ig20041975/In-Situ-Water-Quality-Sensor/media/sensor_package_2025 2.png

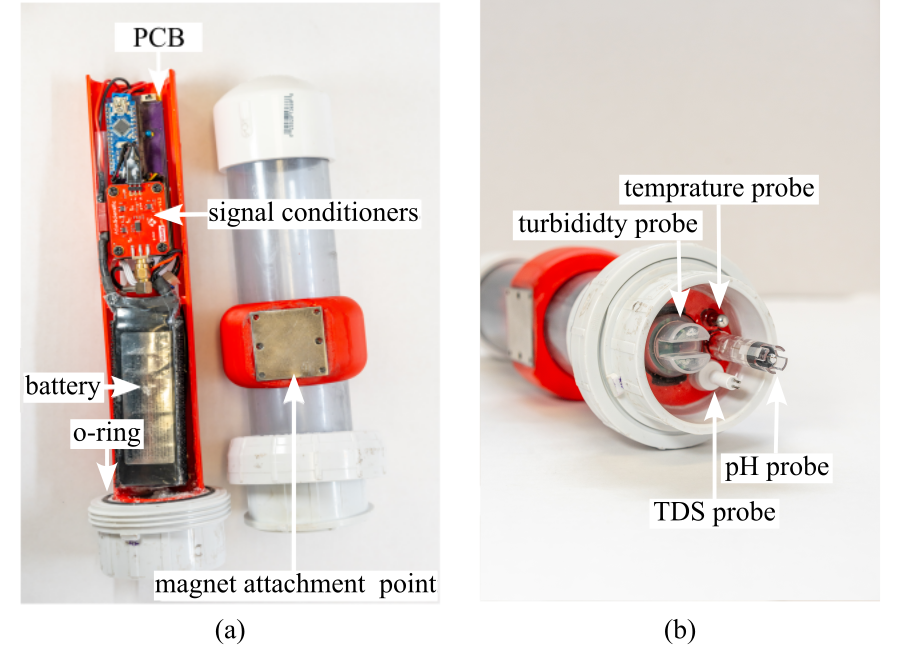
media/sensor_package_2025 2.png
