ig20041975/In-Situ-Water-Quality-Sensor/System_development/Jocassee/V0.5.1/Buoy/media/clamshell with roof.png

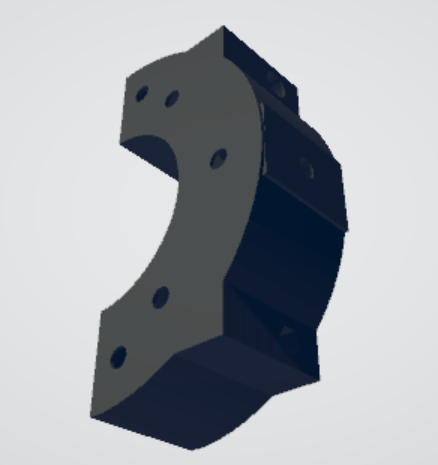
System_development/Jocassee/V0.5.1/Buoy/media/clamshell with roof.png
