ig20041975/In-Situ-Water-Quality-Sensor/System_development/Jocassee/V0.5.1/Buoy/media/sphere style buoy.png

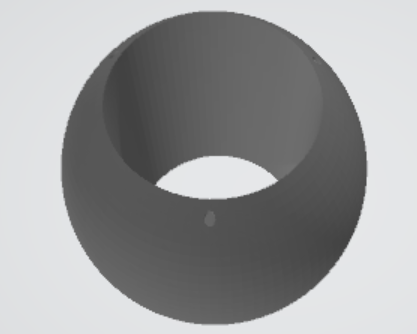
System_development/Jocassee/V0.5.1/Buoy/media/sphere style buoy.png
