ig20041975/In-Situ-Water-Quality-Sensor/System_development/Jocassee/V0.5.1/BIll_Of_Matirials/Parts for Int-Situ-Water-Quality-Sensor.docx

All Container Parts

Item (# of parts) (Grainger Part Number)

- PVC Female Adaptor (1) (1WJY4)
- Epoxy
- 3” Round Atrium Grate (1) (Home Depot)
- ABS Male Adaptor (1) (1WJD3)
- 1.5” by 1.5” steel plate (1) (We have steel)
- 14” long 2” diameter PVC Pipe (1) (788VR8 for 10ft white, 1AAZ8 for 8ft clear)
- ½” long ¼” diameter nut and bolt (2) (we have)
- 2” diameter O-ring (2) (2KAE2 is a 25 pack)
- Battery and PCB board tray 3D print (1)
- Steel plate holder 3D print (1)
- Buoy 3D Print (1)
- Spray Foam door and window
- PVC Glue (We have)

All Electronics

- Analog to digital converting PCB board (3)
- PCB board (1)
- Arduino Mini (1)
- JST XH 3 prong snap-in female wire connector (3)
- Dupont 3 prong female wire connector (3)
- pH sensor (1) (https://www.amazon.com/Atlas-Scientific-Consumer-Grade-Probe/dp/B07VDMNB92)
- Temperature sensor (1) (https://www.amazon.com/HiLetgo-DS18B20-Temperature-Stainless-Waterproof/dp/B00M1PM55K)
- TDS sensor (1) (https://www.amazon.com/KEYESTUDIO-Quality-Monitoring-XH2-54-3Pin-Connector/dp/B08DGLY3J2?link_code=qs)
- Turbidity sensor (1) (https://www.newark.com/amphenol-advanced-sensors/tsd-10/turbidity-sensor-5vdc-phototransistor/dp/18X9859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)
