ig20041975/In-Situ-Water-Quality-Sensor/System_development/Jocassee/V0.5.1/BIll_Of_Matirials/Water quality V0.5 BOM.xlsx

Sheet: Electronics BOM
PCB Reference | Component spec / part number | Qty | Unit cost (USD) | Net cost (USD) | Vendor 1 | Vendor 2 | Vendor 3
C1 0.1uF | Capacitor_SMD:C_1206_3216Metric_Pad1.33x1.80mm_HandSolder | 1 | 0.11 | 0.11 | https://www.digikey.com/en/products/detail/nextgen-components/1206B104K500BD/15776047
U3 | SWITCH OS102011MS2QN1 | 1 | 0.71 | 0.71 | https://www.digikey.com/en/products/detail/c-k/OS102011MS2QN1/411602 | https://www.mouser.com/ProductDetail/CK/OS102011MS2QN1?qs=WtljUlYws5RvQ1hEv876nQ%3D%3D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 | https://www.jameco.com/z/OS102011MS2QN1-C-K-Slide-Switch-SPDT-ON-ON-100mA-12VDC-Through-Hole-5-08mm-Pitch_2313927.html
D1 | LED 3.0mm | 1 | 0.16 | 0.16 | https://www.digikey.com/en/products/detail/w%C3%BCrth-elektronik/151033RS03000/4490003
U2 | SD card module | 1 | 1.69 | 1.69 | https://www.ebay.com/itm/203852249807?_skw=SD+card+module+mini&itmmeta=01JWS7YRSNYRE9JPQ1403XF1SB
A1 | Arduino Nano | 1 | 3.67 | 3.67 | https://www.ebay.com/itm/283932038203?_skw=arduino+nano&itmmeta=01JWS81PY2BK5W7AA2FK7T4DBS
U6 | DS3231M+ | 1 | 10.98 | 10.98 | https://www.digikey.com/en/products/detail/analog-devices-inc-maxim-integrated/DS3231M-TRL/2402421 | https://www.mouser.com/ProductDetail/Analog-Devices-Maxim-Integrated/DS3231M+TRL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
BT1 | Coin cell Battery Holder BK-870 | 1 | 0.58 | 0.58 | https://www.digikey.com/en/products/detail/mpd-memory-protection-devices/BK-870/3829737
U8 | 3pin XH2.54 male connector (https://www.digikey.com/en/products/detail/jst-sales-america-inc/B3B-XH-A/1651046) | 1 | 0.13 | 0.13 | https://www.digikey.com/en/products/detail/jst-sales-america-inc/B3B-XH-A/1651046
R2 470ohm | Resistor_SMD:R_1206_3216Metric_Pad1.30x1.75mm_HandSolder | 1 | 0.1 | 0.1 | https://www.digikey.com/en/products/detail/bourns-inc/CR1206-JW-471ELF/3741054
R1 4.7K | Resistor_SMD:R_1206_3216Metric_Pad1.30x1.75mm_HandSolder | 1 | 0.1 | 0.1 | https://www.digikey.com/en/products/detail/bourns-inc/CR1206-JW-472ELF/3785627
N/A | Coin cell battery CR-1025-ND | 1 | 1.09 | 1.09 | https://www.digikey.com/en/products/detail/jauch-quartz/CR1025/16399048
N/A | 11.1V 3300mAH Lipo battery with T connector | 1 | 46.72 | 46.72 | https://us.ovonicshop.com/products/2-ovonic-3000mah-3s-50c-lipo-battery-11-1v-long-with-t-plug-for-aircraft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 | https://www.ebay.com/itm/184508325888?chn=ps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 | https://www.motionrc.com/products/admiral-3300mah-3s-11-1v-30c-lipo-battery-with-t-connector-epr33003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
N/A | Atlas pH conditioning circuit | 1 | 26.11 | 26.11 | https://www.digikey.com/en/products/detail/atlas-scientific/SRV-PH/16003016?gad_source=1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
N/A | Turbidity conditioning circuit and sensor | 1 | 9.9 | 9.9 | https://www.digikey.com/en/products/detail/dfrobot/SEN0189/6588606?gad_source=1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 | https://www.keyestudio.com/products/keyestudio-turbidity-sensor-v10-with-wires-compatible-with-arduino-for-water-testing
N/A | pH probe ENV 30 | 1 | 49.99 | 49.99 | https://www.digikey.com/en/products/detail/atlas-scientific/ENV-30-PH/16003028?gad_source=1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 | https://atlas-scientific.com/probes/consumer-grade-ph-probe/
N/A | TDS probe and conditioning circuit | 1 | 19.95 | 19.95 | https://www.ebay.com/itm/184291373846?chn=ps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 | https://www.keyestudio.com/products/keyestudio-tds-meter-v10-board-module-water-meter-filter-measuring-water-quality-for-arduino-unor3
N/A | ds18b20 temperature sensor | 1 | 2.55 | 2.55 | https://www.ebay.com/itm/224193475936?_skw=ds18b20&itmmeta=01JWS9436Y9FERAQTKDM3HA2HJ | https://www.dfrobot.com/product-689.html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
N/A | Male T connector for lipo | 1 | 1.25 | 1.25 | https://www.digikey.com/en/products/detail/sparkfun-electronics/11864/6818769?gad_source=1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 | https://rcbattery.com/deans-style-t-connector-plug-male-side-5pcs-bag.html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
N/A | 15 pin female header 2.54 mm | 2 | 2.2 | 4.4 | https://www.digikey.com/en/products/detail/samtec-inc/SSW-115-01-F-S/7879494?gad_source=1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
N/A | PCB itself | 1 | 8 | 8 | https://oshpark.com/
 |  |  | Total | 188.08

Sheet: Fixture BOM
Component | Qty per sensor | Unit price (USD) | Net price (USD) | vendor 1 | vendor 2 | vendor 3
PVC union | 1 | 19.56 | 19.56 | https://www.grainger.com/product/22FL17?RIID=51819294775&GID=729415832 | https://www.homedepot.com/pep/Apollo-2-in-x-2-in-PVC-Slip-Joint-x-Slip-Joint-Union-PVCU2/317901067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
Schedule 40 clear PVC pipe | 10 inches | 69.69 | 7.26 | https://www.grainger.com/product/1AAZ8?gclsrc=aw.ds&gad_source=1&gad_campaignid=21375667808
Schedule 40 socket cap | 1 | 1.47 | 1.47 | https://www.grainger.com/product/22FJ37?RIID=51819294775&GID=729415832 | https://www.homedepot.com/pep/Charlotte-Pipe-2-in-PVC-Socket-Schedule-40-Pressure-Cap-PVC021161600HD/203811678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 | https://www.homedepot.com/pep/Charlotte-Pipe-2-in-OD-PVC-Test-Cap-Fitting-PVC-00132-0800HD/203947220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
M3 standoofs 8mm | 12 | 1.13 | 13.56 | https://www.digikey.com/en/products/detail/w%C3%BCrth-elektronik/971080365/9488753
M3 standoffs 6mm | 4 | 0.85 | 3.4 | https://www.digikey.com/en/products/detail/w%C3%BCrth-elektronik/971060365/9488747
M3 nylon hex nut | 4 | 0.13 | 0.52 | https://www.digikey.com/en/products/detail/keystone-electronics/4688/4499297?gad_source=1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
2 part clear epoxy | 1 pack | 47.86 | 47.86 | https://www.grainger.com/product/25F529?gad_source=1&gad_campaignid=21369464154&gclsrc=aw.ds | https://www.ebay.com/itm/365353922077?itmmeta=01JZNA1PV76QEB7T5CVVGGADC6 | https://www.grainger.com/product/PC-PRODUCTS-Epoxy-Adhesive-PC-11-4AUV9?opr=ODOH&analytics=FM:Order%20History
 |  |  | 93.63
