ig20041975/In-Situ-Water-Quality-Sensor/System_development/Jocassee/V0.5.1/Buoy/Buoy Torus v1.stl

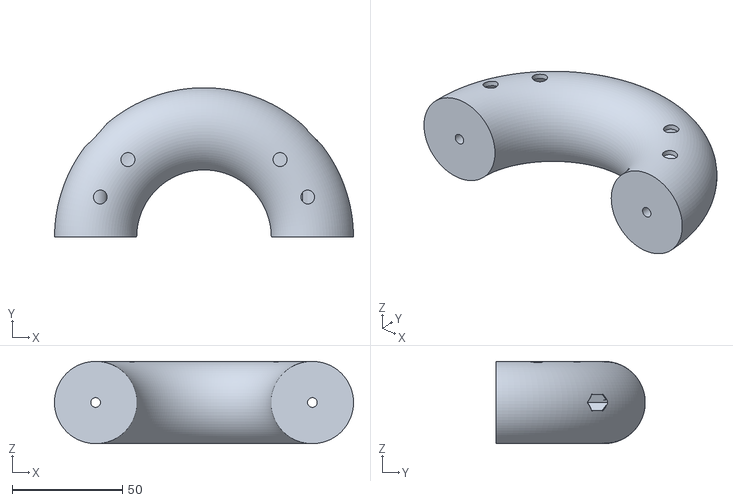
[picture p6: CAD file, 2025-07-18]
System_development/Jocassee/V0.5.1/Buoy/Buoy Torus v1.stl
135.4 x 67.7 x 37.2
