ig20041975/In-Situ-Water-Quality-Sensor/System_development/Jocassee/V0.5.1/Chassis/CAD model of Water Sensor/Printable Grate v2.stl

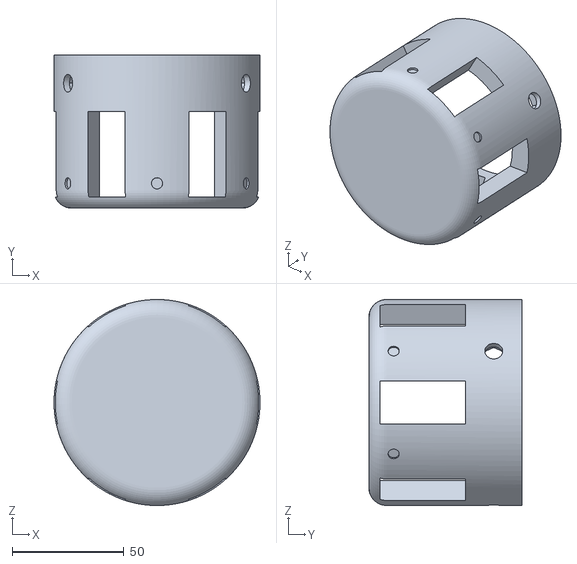
[picture p7: CAD file, 2025-08-21]
System_development/Jocassee/V0.5.1/Chassis/CAD model of Water Sensor/Printable Grate v2.stl
92.0 x 68.5 x 92.0
