ig20041975/In-Situ-Water-Quality-Sensor/System_development/Jocassee/V0.5.1/Drop Mechanism/Bouy.stl

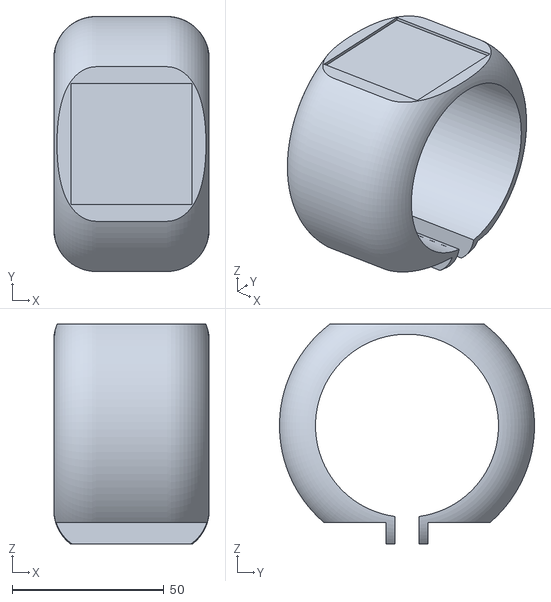
[picture p8: CAD file, 2025-07-17]
System_development/Jocassee/V0.5.1/Drop Mechanism/Bouy.stl
51.0 x 84.1 x 72.4
