ig20041975/In-Situ-Water-Quality-Sensor/System_development/Jocassee/V0.5.1/Chassis/CAD model of Water Sensor/Printable Grate v1.step

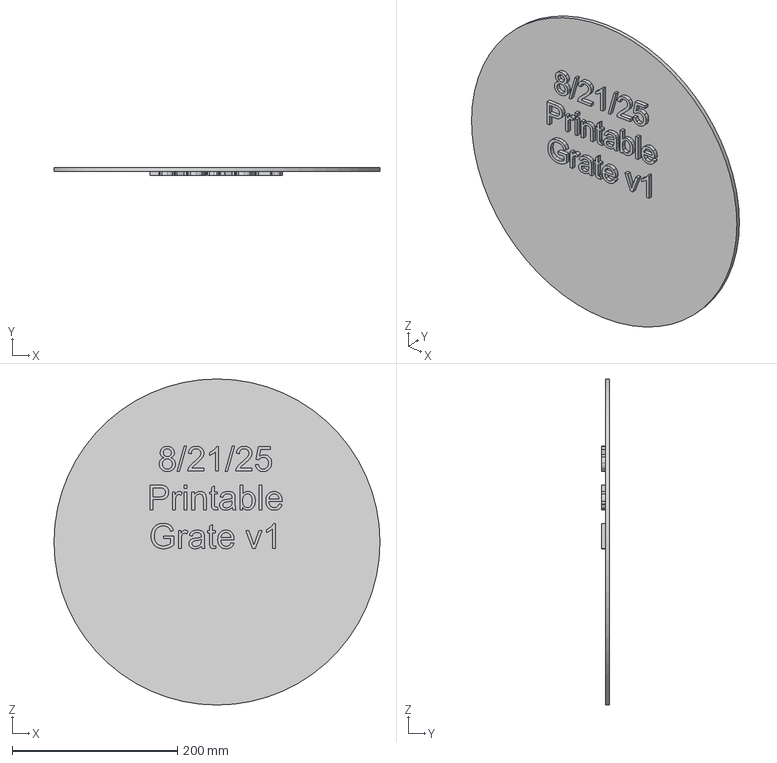
[picture p9: CAD file, 2025-08-21]
System_development/Jocassee/V0.5.1/Chassis/CAD model of Water Sensor/Printable Grate v1.step
395.0 x 10.0 x 395.0 mm
