ig20041975/In-Situ-Water-Quality-Sensor/System_development/Jocassee/V0.5.1/Chassis/CAD model of Water Sensor/Printable Grate.3mf

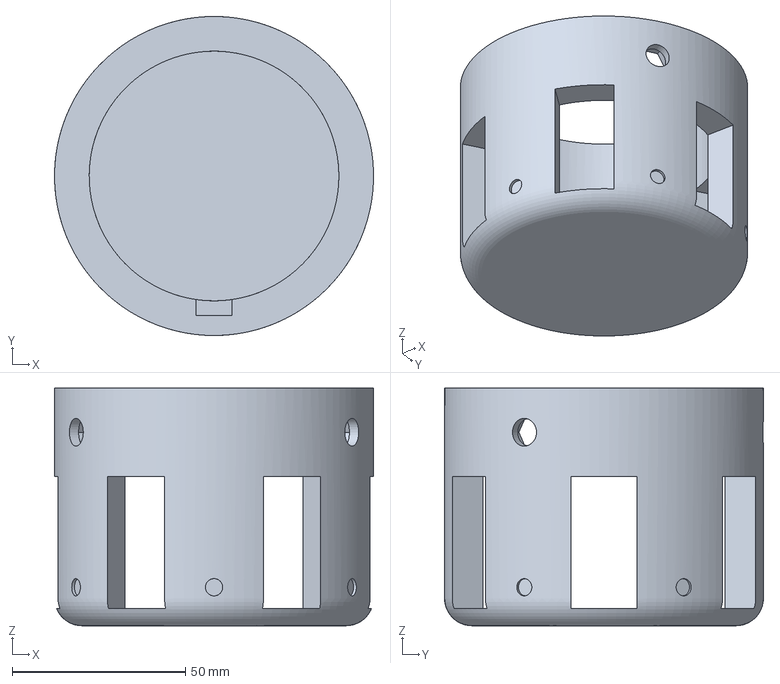
[picture p10: CAD file, 2025-08-19]
System_development/Jocassee/V0.5.1/Chassis/CAD model of Water Sensor/Printable Grate.3mf
92.0 x 92.0 x 68.5 mm
