ig20041975/In-Situ-Water-Quality-Sensor/System_development/Jocassee/V0.5.1/Chassis/CAD model of Water Sensor/PCB tray CAD.3mf

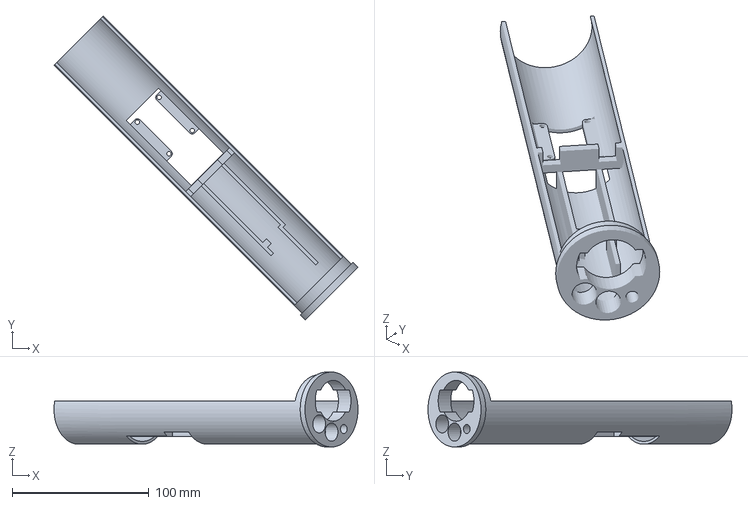
[picture p11: CAD file, 2025-07-17]
System_development/Jocassee/V0.5.1/Chassis/CAD model of Water Sensor/PCB tray CAD.3mf
222.3 x 222.3 x 54.8 mm
