ig20041975/In-Situ-Water-Quality-Sensor/System_development/Jocassee/V0.5.1/Chassis/CAD model of Water Sensor/Spacer for PCB boards.stl

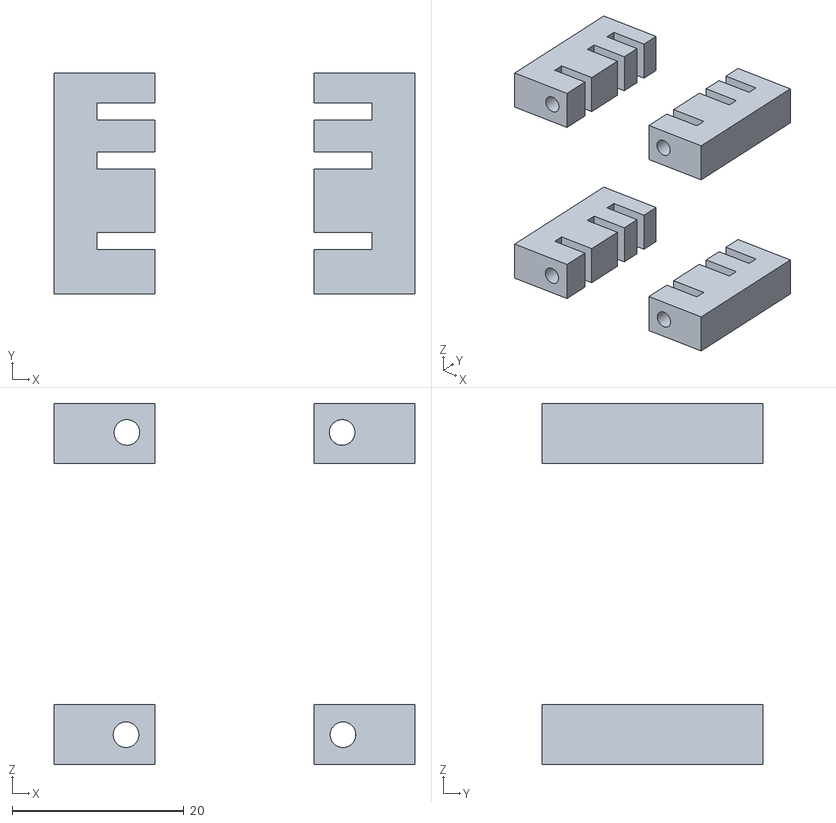
[picture p12: CAD file, 2025-07-17]
System_development/Jocassee/V0.5.1/Chassis/CAD model of Water Sensor/Spacer for PCB boards.stl
42.1 x 25.7 x 42.2
