ig20041975/In-Situ-Water-Quality-Sensor/System_development/Jocassee/V0.5.1/Chassis/CAD model of Water Sensor/Water_Sensor_Cap.stl

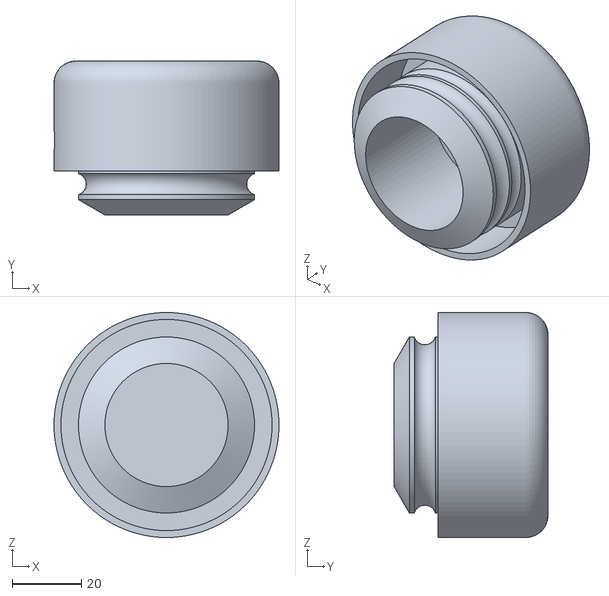
[picture p13: CAD file, 2025-07-17]
System_development/Jocassee/V0.5.1/Chassis/CAD model of Water Sensor/Water_Sensor_Cap.stl
65.0 x 44.4 x 65.0
