ig20041975/In-Situ-Water-Quality-Sensor/System_development/Jocassee/V0.5.1/Buoy/eyebolt compatible/Clamshell with roof/CE3V3KE_buoy version 16.5.4 eyeboltipt.3mf

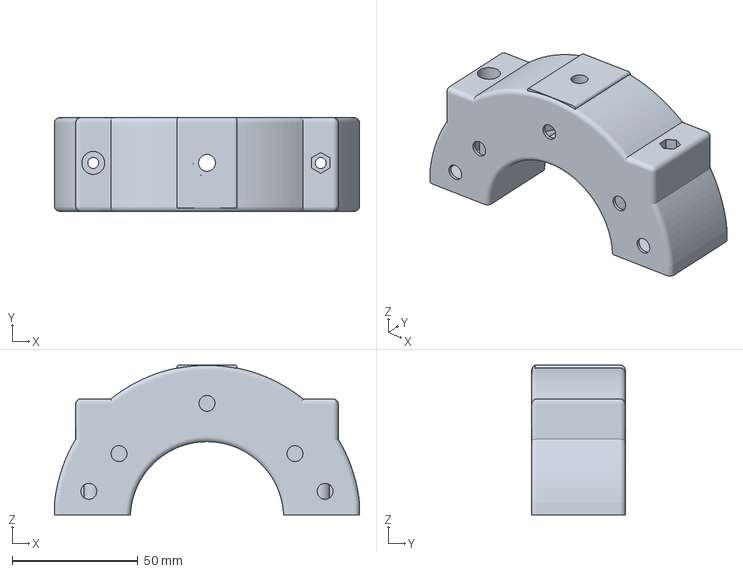
[picture p15: CAD file, 2025-07-17]
System_development/Jocassee/V0.5.1/Buoy/eyebolt compatible/Clamshell with roof/CE3V3KE_buoy version 16.5.4 eyeboltipt.3mf
121.3 x 37.2 x 59.6 mm
