ig20041975/In-Situ-Water-Quality-Sensor/System_development/Jocassee/V0.5.1/Buoy/eyebolt compatible/clamshell no roof/buoy versio 15.7 clamshell no roof.stl

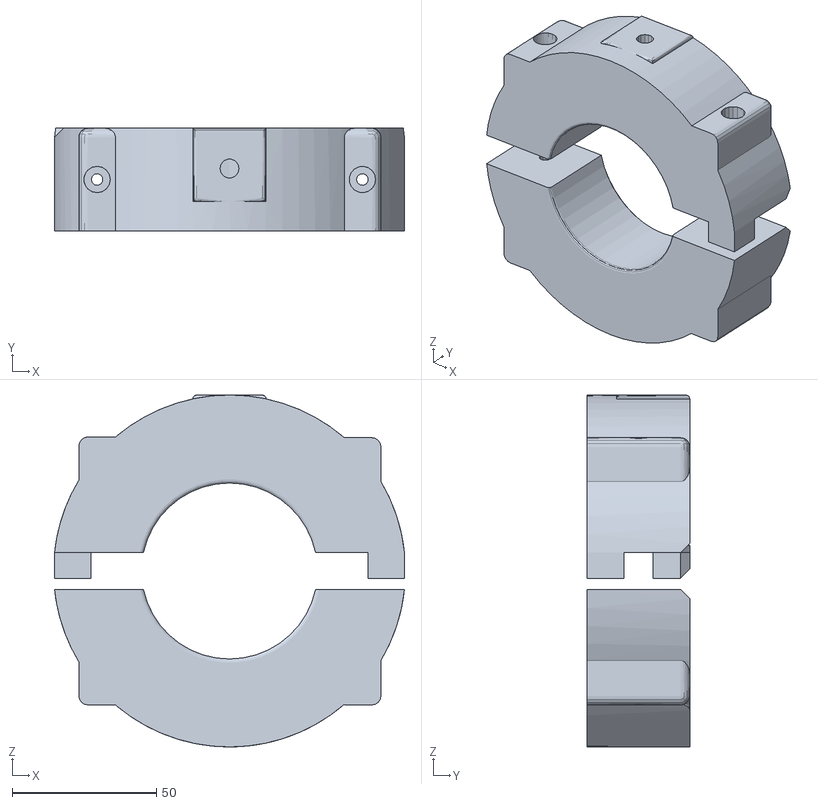
[picture p16: CAD file, 2025-06-23]
System_development/Jocassee/V0.5.1/Buoy/eyebolt compatible/clamshell no roof/buoy versio 15.7 clamshell no roof.stl
121.3 x 35.6 x 121.9
