ig20041975/In-Situ-Water-Quality-Sensor/System_development/Jocassee/V0.5.1/Buoy/eyebolt compatible/Clamshell with roof/buoy versio 15.5 clamshell with ibolt connection.stl

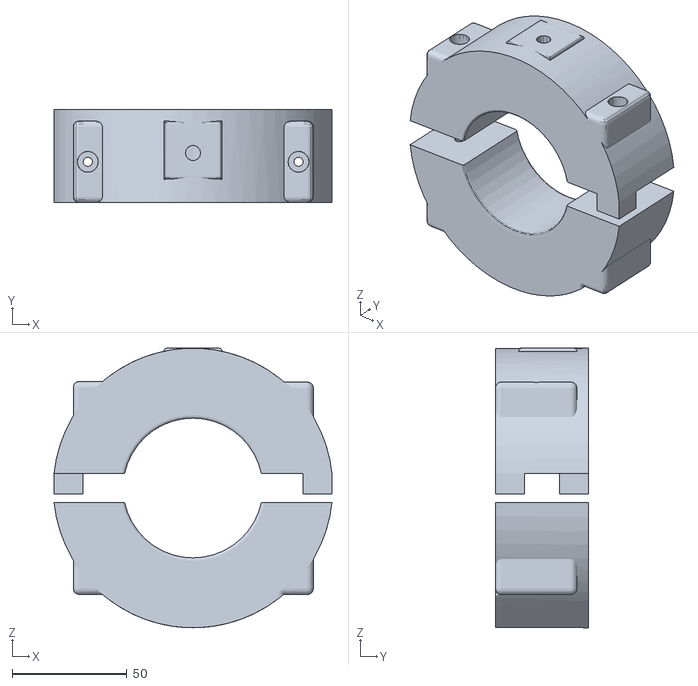
[picture p17: CAD file, 2025-07-17]
System_development/Jocassee/V0.5.1/Buoy/eyebolt compatible/Clamshell with roof/buoy versio 15.5 clamshell with ibolt connection.stl
121.3 x 40.6 x 121.9
