ig20041975/In-Situ-Water-Quality-Sensor/System_development/Jocassee/V0.5.1/Buoy/eyebolt compatible/Clamshell with roof/buoy version 16.5.2 edited eyeboltipt.stl

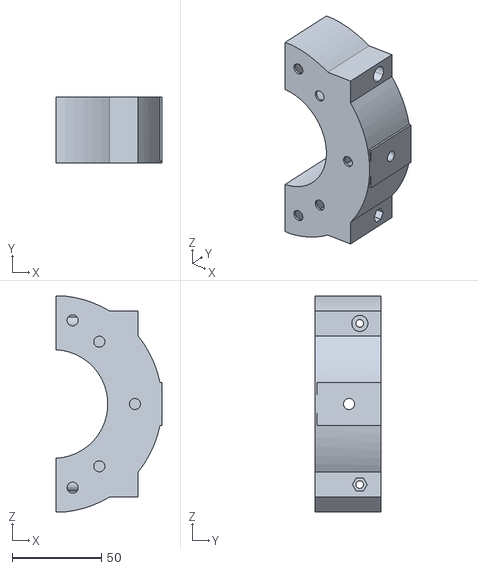
[picture p18: CAD file, 2025-07-17]
System_development/Jocassee/V0.5.1/Buoy/eyebolt compatible/Clamshell with roof/buoy version 16.5.2 edited eyeboltipt.stl
59.6 x 37.2 x 121.3
