ig20041975/In-Situ-Water-Quality-Sensor/System_development/Jocassee/V0.5.1/Buoy/eyebolt compatible/Clamshell with roof/buoy version 16.5.5 eyeboltipt.step

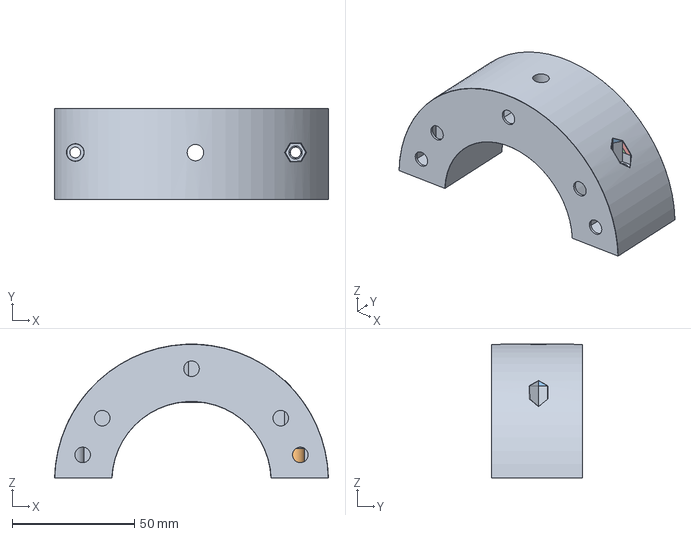
[picture p19: CAD file, 2025-07-17]
System_development/Jocassee/V0.5.1/Buoy/eyebolt compatible/Clamshell with roof/buoy version 16.5.5 eyeboltipt.step
112.0 x 37.2 x 54.7 mm
