ig20041975/In-Situ-Water-Quality-Sensor/System_development/Jocassee/V0.5.1/Buoy/eyebolt compatible/Clamshell with roof/buoy version 16.stl

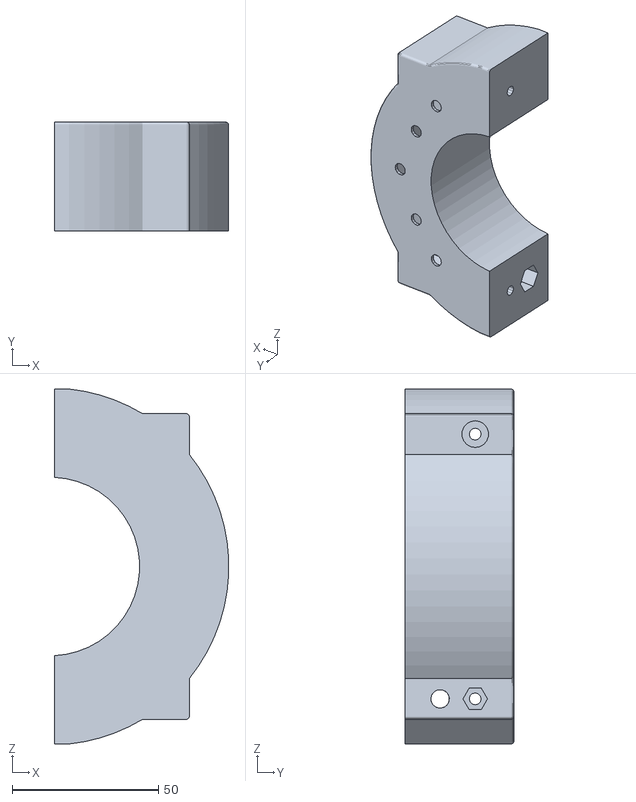
[picture p20: CAD file, 2025-06-23]
System_development/Jocassee/V0.5.1/Buoy/eyebolt compatible/Clamshell with roof/buoy version 16.stl
59.6 x 37.2 x 121.3
