ig20041975/In-Situ-Water-Quality-Sensor/(list of files, cad)

Other CAD files:
System_development/Jocassee/V0.5.1/Chassis/CAD model of Water Sensor/Printable Grate.gcode.3mf
System_development/Jocassee/V0.5.1/Buoy/eyebolt compatible/Clamshell with roof/buoy version 16.5.4 eyeboltipt.3mf
System_development/Jocassee/V0.5.1/Buoy/eyebolt compatible/Clamshell with roof/buoy version 16.5.4 eyeboltipt v1.step
System_development/Jocassee/V0.5.0/Buoy/Buoy 11 8inx1in shpere.ipt
System_development/Jocassee/V0.5.0/Buoy/Buoy 11 8inx1in shpere.stl
System_development/Jocassee/V0.5.0/Buoy/Buoy 12 7inx1in shpere.ipt
System_development/Jocassee/V0.5.0/Buoy/Buoy 12 7inx1in shpere.stl
System_development/Jocassee/V0.5.0/Buoy/OldVersions/buoy version 16.0002.ipt
System_development/Jocassee/V0.5.0/Buoy/buoy version 15.6 expairamenting with wall thinknes (do not print this yet).ipt
System_development/Jocassee/V0.5.1/Buoy/Buoy Torus v1.ipt
System_development/Jocassee/V0.5.1/Buoy/OldVersions/clamshell buoys/buoy versio 15 clamshellipt.0001.ipt
System_development/Jocassee/V0.5.1/Buoy/OldVersions/sphere buoys/Buoy 11 8inx1in shpere.ipt
System_development/Jocassee/V0.5.1/Buoy/OldVersions/sphere buoys/Buoy 11 8inx1in shpere.stl
System_development/Jocassee/V0.5.1/Buoy/OldVersions/sphere buoys/Buoy 12 7inx1in shpere.ipt
System_development/Jocassee/V0.5.1/Buoy/OldVersions/sphere buoys/Buoy 12 7inx1in shpere.stl
System_development/Jocassee/V0.5.1/Buoy/eyebolt compatible/Clamshell with roof/OldVersions/buoy version 16.5.3 eyeboltipt.0001.ipt
System_development/Jocassee/V0.5.1/Buoy/eyebolt compatible/Clamshell with roof/buoy versio 15.1 clamshell with ibolt connection.ipt
System_development/Jocassee/V0.5.1/Buoy/eyebolt compatible/Clamshell with roof/buoy versio 15.5 clamshell with ibolt connection.ipt
System_development/Jocassee/V0.5.1/Buoy/eyebolt compatible/Clamshell with roof/buoy version 16.5 edited eyeboltipt.0001.ipt
System_development/Jocassee/V0.5.1/Buoy/eyebolt compatible/Clamshell with roof/buoy version 16.5 edited eyeboltipt.ipt
System_development/Jocassee/V0.5.1/Buoy/eyebolt compatible/Clamshell with roof/buoy version 16.5 edited eyeboltipt.stl
System_development/Jocassee/V0.5.1/Buoy/eyebolt compatible/Clamshell with roof/buoy version 16.5.1 edited eyeboltipt.dwg
System_development/Jocassee/V0.5.1/Buoy/eyebolt compatible/Clamshell with roof/buoy version 16.5.1 edited eyeboltipt.ipt
System_development/Jocassee/V0.5.1/Buoy/eyebolt compatible/Clamshell with roof/buoy version 16.5.1 edited eyeboltipt.stl
System_development/Jocassee/V0.5.1/Buoy/eyebolt compatible/Clamshell with roof/buoy version 16.5.2 edited eyeboltipt.ipt
System_development/Jocassee/V0.5.1/Buoy/eyebolt compatible/Clamshell with roof/buoy version 16.5.3 eyeboltipt.3mf
System_development/Jocassee/V0.5.1/Buoy/eyebolt compatible/Clamshell with roof/buoy version 16.5.3 eyeboltipt.ipt
System_development/Jocassee/V0.5.1/Buoy/eyebolt compatible/Clamshell with roof/buoy version 16.5.3 eyeboltipt.stl
System_development/Jocassee/V0.5.1/Buoy/eyebolt compatible/Clamshell with roof/buoy version 16.5.4 eyeboltipt.ipt
System_development/Jocassee/V0.5.1/Buoy/eyebolt compatible/Clamshell with roof/buoy version 16.5.4 eyeboltipt.stl
System_development/Jocassee/V0.5.1/Buoy/eyebolt compatible/Clamshell with roof/buoy version 16.ipt
System_development/Jocassee/V0.5.1/Buoy/eyebolt compatible/clamshell no roof/buoy versio 15.7 clamshell no roof.0001.ipt
System_development/Jocassee/V0.5.1/Buoy/eyebolt compatible/clamshell no roof/buoy versio 15.7 clamshell no roof.ipt
System_development/Jocassee/V0.5.1/Buoy/eyebolt compatible/non-clamshell designs/Bouy versioun 14 not an stl file.ipt
System_development/Jocassee/V0.5.1/Buoy/eyebolt compatible/non-clamshell designs/I-bolt compatable floater for in-situ water detection v13.ipt
System_development/Jocassee/V0.5.1/Buoy/eyebolt compatible/non-clamshell designs/i-bolt compatible buoy v13 square.ipt
System_development/Jocassee/V0.5.1/Chassis/CAD model of Water Sensor/Assembled Water Sensor Chassi.iam
System_development/Jocassee/V0.5.1/Chassis/CAD model of Water Sensor/CADs for Water Sensor assembly/Arc Water Sensor.ipt
System_development/Jocassee/V0.5.1/Chassis/CAD model of Water Sensor/CADs for Water Sensor assembly/Battery for Water Sensor.ipt
System_development/Jocassee/V0.5.1/Chassis/CAD model of Water Sensor/CADs for Water Sensor assembly/Light Water Sensor.ipt
System_development/Jocassee/V0.5.1/Chassis/CAD model of Water Sensor/CADs for Water Sensor assembly/Male Adaptor to Water Sensor.ipt
System_development/Jocassee/V0.5.1/Chassis/CAD model of Water Sensor/CADs for Water Sensor assembly/OldVersions/PCB Board.0002.ipt
System_development/Jocassee/V0.5.1/Chassis/CAD model of Water Sensor/CADs for Water Sensor assembly/PCB Board.ipt
System_development/Jocassee/V0.5.1/Chassis/CAD model of Water Sensor/CADs for Water Sensor assembly/Pipe Joiner for Water Sensor.ipt
System_development/Jocassee/V0.5.1/Chassis/CAD model of Water Sensor/CADs for Water Sensor assembly/Temp Water Sensor.ipt
System_development/Jocassee/V0.5.1/Chassis/CAD model of Water Sensor/CADs for Water Sensor assembly/Water Sensor Grate.ipt
System_development/Jocassee/V0.5.1/Chassis/CAD model of Water Sensor/CADs for Water Sensor assembly/Water Sensor Shaft (For assembly only).ipt
System_development/Jocassee/V0.5.1/Chassis/CAD model of Water Sensor/CADs for Water Sensor assembly/pH Sensor.ipt
System_development/Jocassee/V0.5.1/Chassis/CAD model of Water Sensor/OldVersions/Assembled Water Sensor Chassi.0010.iam
System_development/Jocassee/V0.5.1/Chassis/CAD model of Water Sensor/OldVersions/PCB tray CAD.0050.ipt
System_development/Jocassee/V0.5.1/Chassis/CAD model of Water Sensor/OldVersions/PCB tray CAD.0051.ipt
System_development/Jocassee/V0.5.1/Chassis/CAD model of Water Sensor/OldVersions/Printable Grate.0003.ipt
System_development/Jocassee/V0.5.1/Chassis/CAD model of Water Sensor/OldVersions/Printable Grate.0004.ipt
System_development/Jocassee/V0.5.1/Chassis/CAD model of Water Sensor/OldVersions/Printable Grate.0005.ipt
System_development/Jocassee/V0.5.1/Chassis/CAD model of Water Sensor/OldVersions/Printable Grate.0007.ipt
System_development/Jocassee/V0.5.1/Chassis/CAD model of Water Sensor/OldVersions/Spacer for PCB boards.0019.ipt
System_development/Jocassee/V0.5.1/Chassis/CAD model of Water Sensor/OldVersions/Water_Sensor_Cap.0028.ipt
System_development/Jocassee/V0.5.1/Chassis/CAD model of Water Sensor/OldVersions/Water_Sensor_Cap.0029.ipt
System_development/Jocassee/V0.5.1/Chassis/CAD model of Water Sensor/OldVersions/Water_Sensor_Cap.0030.ipt
System_development/Jocassee/V0.5.1/Chassis/CAD model of Water Sensor/PCB tray CAD.ipt
System_development/Jocassee/V0.5.1/Chassis/CAD model of Water Sensor/PCB tray CAD.stl
System_development/Jocassee/V0.5.1/Chassis/CAD model of Water Sensor/Printable Grate v1.stl
System_development/Jocassee/V0.5.1/Chassis/CAD model of Water Sensor/Printable Grate v2.ipt
System_development/Jocassee/V0.5.1/Chassis/CAD model of Water Sensor/Printable Grate.ipt
System_development/Jocassee/V0.5.1/Chassis/CAD model of Water Sensor/Printable Grate.stl
System_development/Jocassee/V0.5.1/Chassis/CAD model of Water Sensor/RC plane design copy (wider design).f3d
System_development/Jocassee/V0.5.1/Chassis/CAD model of Water Sensor/Spacer for PCB boards.ipt
System_development/Jocassee/V0.5.1/Chassis/CAD model of Water Sensor/Water_Sensor_Cap.ipt
System_development/Jocassee/V0.5.1/Chassis/CADs for Water Sensor assembly/OldVersions/PCB Board.0002.ipt
System_development/Jocassee/V0.5.1/Chassis/CADs for Water Sensor assembly/PCB Board.ipt
System_development/Jocassee/V0.5.1/Drop Mechanism/DroneDeploymentMechanism.ipt
System_development/Jocassee/V0.5.1/Drop Mechanism/OldVersions/Part2.0001.ipt
