ig20041975/In-Situ-Water-Quality-Sensor/System_development/Jocassee/V0.5.1/PCB/V0.5.0/V0.5.0.kicad_pcb

## KiCad design System_development/Jocassee/V0.5.1/PCB/V0.5.0/V0.5.0.kicad_pcb (2025-07-08)

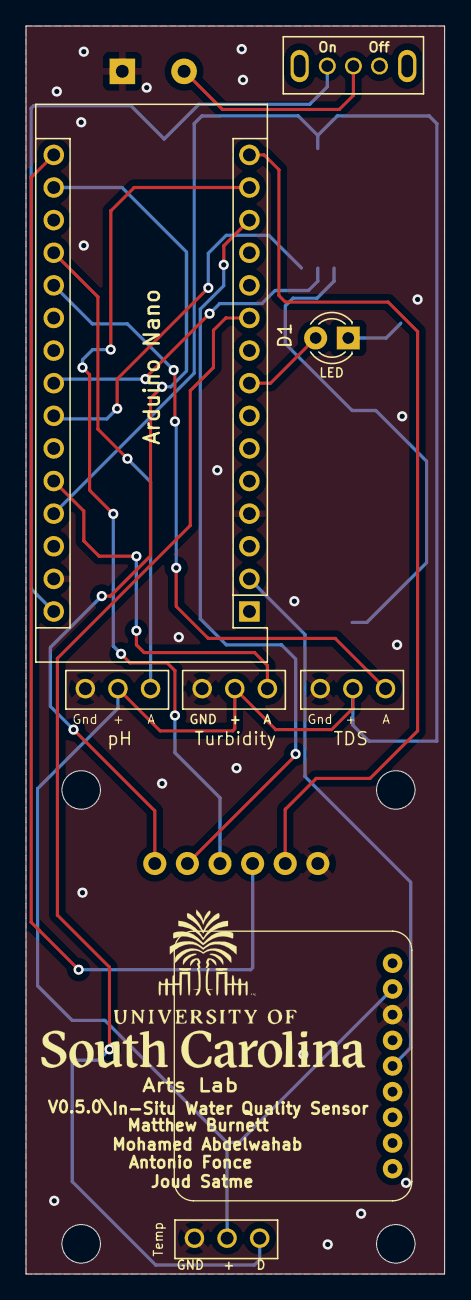
[picture p21: board V0.5.0.kicad_pcb from above]

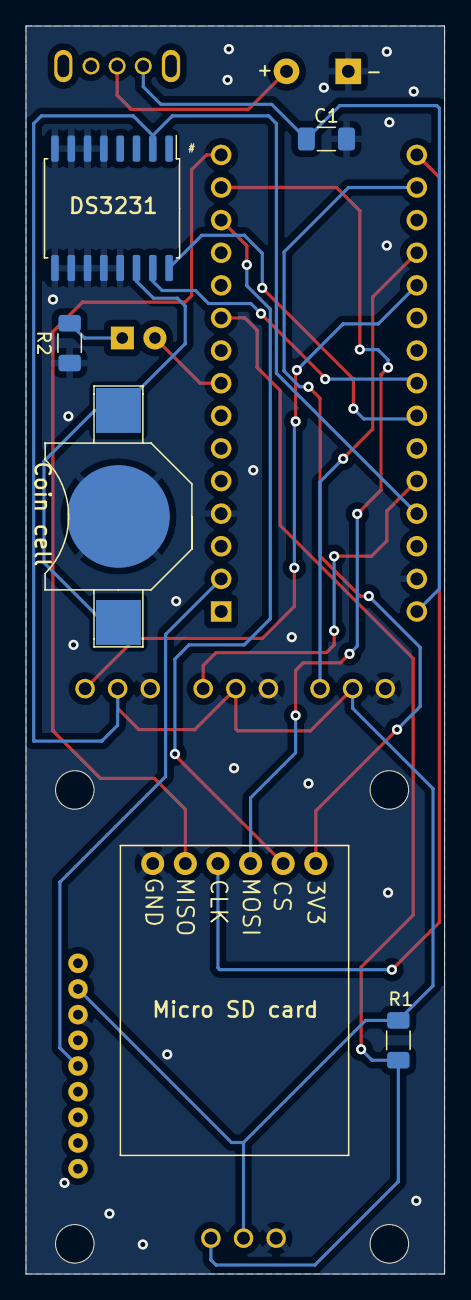
[picture p22: board V0.5.0.kicad_pcb from below]

Board: 2 copper layers, 32.6 x 97.2 mm, 15 parts (7 on the bottom side), 19 nets.

Parts:
A1: Arduino_Nano_v3.x; Arduino_Nano
BT1: Battery_Cell; battery_holder_10mm
C1: C; C_1206_3216Metric_Pad1.33x1.80mm_HandSolder
D1: LED; LED_D3.0mm
R1, R2: R; R_1206_3216Metric_Pad1.30x1.75mm_HandSolder
U1: water_Battery; Battery_Input
U2: SD
U3: switch; grounded_switch
U4: pH; phraails
U5: Sensor; TDS
U6: DS3231M; SOIC-16W_7.5x10.3mm_P1.27mm
U7: Sensor; Turbidity
U8: Temp; Temp.
U9: GPS Module

Connections:
GND: A1.4 (GND), A1.29 (GND), BT1.2 (-), C1.2, R2.2, U1.2 (Gnd), U2.6 (GND), U4.1 (GND), U5.1 (GND), U6.5 (GND), U6.6 (GND), U6.7 (GND), U6.8 (GND), U6.9 (GND), U6.10 (GND), U6.11 (GND), U6.12 (GND), U6.13 (GND), U7.1 (GND), U8.1 (Gnd), U9.7 (GND)
unnamed: A1.17 (3V3), U2.1 (3V)
unnamed: A1.27 (+5V), R1.2, U4.2 (+), U5.2 (+), U6.2 (VCC), U7.2 (+), U8.2 (5V), U9.8 (VIN)
unnamed: A1.19 (A0), U4.3 (A)
unnamed: A1.20 (A1), U5.3 (A)
unnamed: A1.23 (A4), U6.15 (SDA)
unnamed: A1.24 (A5), U6.16 (SCL)
unnamed: A1.26 (A7), U7.3 (A)
unnamed: A1.2 (D0/RX), U9.5 (TX)
unnamed: A1.8 (D5), D1.2 (A)
unnamed: A1.10 (D7), R1.1, U8.3 (D)
unnamed: A1.13 (D10), U2.2 (CS)
unnamed: A1.14 (D11), U2.3 (Mosi)
unnamed: A1.15 (D12), U2.5 (Miso)
unnamed: A1.16 (D13), U2.4 (CLK)
unnamed: A1.30 (VIN), C1.1, U3.3 (PO)
unnamed: BT1.1 (+), U6.14 (VBAT)
unnamed: D1.1 (K), R2.1
unnamed: U1.1 (Power), U3.2 (PI)
