ig20041975/In-Situ-Water-Quality-Sensor/(commit log)

2025-07-04 buoy version 16.5.4
    16.5.4
    [buoy version 16.5.3 eyeboltipt.3mf, buoy version 16.5.4 eyeboltipt.ipt, buoy version 16.5.4 eyeboltipt.stl]
2025-07-17 Create sensor_package_2025 2.png
2025-07-18 Buoy Torus
    First version
    [Buoy Torus v1.ipt, Buoy Torus v1.stl]
2025-08-19 Printable Grate
    [Printable Grate.3mf, Printable Grate.gcode.3mf]
2025-08-21 Embossed Grate
    [Printable Grate v1.step, Printable Grate v1.stl]
2025-08-21 Embossed Inside
    [Printable Grate v2.ipt, Printable Grate v2.stl]
2026-01-14 Create RC plane design copy (wider design).f3d
    [RC plane design copy (wider design).f3d]
